Specter613/Proyecto_CEREST/docs/Analisis de Estabilidad/Analisis_de_estabilidad.pdf

## Análisis de estabilidad del cuadricóptero

C.E.R.E.S.T.

## Índice

1. Preliminares matemáticos y físicos | 2
2. Cinemática | 3
3. Dinámica traslacional | 4
4. Dinámica rotacional | 4
5. Representación alternativa del subsistema rotacional y translacional | 5
6. Arquitectura del controlador | 7
7. Análisis de estabilidad en lazo cerrado | 9

7.6.1. Con el lazo externo solo P no hay convergencia asintótica demostrable . . | 11
8. Sintonozación de ganancias | 12
9. Nomenclatura | 17

=====================================================================

## 1. Preliminares matemáticos y físicos

### 1.1. Marcos de referencia y convenciones

Se trabaja con dos marcos de referencia:

Marco inercial {I}, fijo a tierra, con ejes X e Y horizontales y eje Z hacia abajo (convención NED: North–East–Down). La posición del centro de masa es r = [x, y, z]

T; la altitud sobre
el suelo es h = −z.

Marco del cuerpo {B}, fijo al vehículo, con su eje zb hacia abajo cuando el vehículo está nive-lado. La orientación se parametriza con ángulos de Euler en convención ZYX: η = [ϕ, θ, ψ]

T
(roll, pitch, yaw).

Las convenciones que fijan todos los signos del documento son:

(C1) Gravedad. La fuerza de gravedad en {I} es mg e3, con e3 = [0, 0, 1]T y g = 9,81 m/s
2
Es positiva en z precisamente porque z apunta hacia abajo. Escribir −mg e3 correspon-dería a un eje Z hacia arriba y es incompatible con esta convención.

(C2) Empuje. El empuje total de los cuatro rotores tiene magnitud U1 ≥ 0 y actúa sobre el vehículo a lo largo de −b3, donde b3 = R(η)e3 es el eje zb expresado en {I}. En vuelo estacionario (hover), U1 = mg.

(C3) Geometría. Configuración en X: los cuatro rotores están sobre las diagonales del chasis, a distancia L del centro de masa; el brazo efectivo para roll y pitch es L/√
2.

(C4) Región de operación. Se trabaja en la región segura

D =

{︁

η : |θ| ≤ π
2 − εθ, |ϕ| ≤ π
2 − εϕ

}︁
, | εθ, εϕ > 0, | (1)

donde cos θ cos ϕ ≥ c0 > 0. Fuera de D la representación ZYX es singular y la proyección del empuje sobre z se anula: ningún resultado de este documento se afirma fuera de D.

### 1.2. Parámetros físicos del vehículo

Tabla 1: Parámetros físicos y aerodinámicos del cuadricóptero (valores reales del sistema).

Símbolo | Descripción | Unidades | Valor
m | Masa total del cuadricóptero | kg | 0,91870
g | Aceleración gravitacional | m/s² | 9,81
L | Distancia del centro a los motores | m | 0,165
kF | Constante de empuje aerodinámico | N/(rad/s)² | 6,53 × 10⁻⁶
kM | Constante de torque/arrastre | N·m/(rad/s)² 8,86 × 10⁻⁸
Ixx | Momento de inercia sobre el eje x | kg·m² | 6,5183 × 10⁻⁴
Iyy | Momento de inercia sobre el eje y | kg·m² | 1,0498 × 10⁻³
Izz | Momento de inercia sobre el eje z | kg·m² | 7,1227 × 10⁻⁴

El tensor de inercia se toma diagonal, I = diag(Ixx, Iyy, Izz), lo cual es consistente con la simetría de la configuración en X.

### 1.3. Herramientas de estabilidad que se utilizarán

El análisis usa dos resultados estándar, que se enuncian aquí en la forma exacta en que se aplicarán en la Sección 7.

Teorema 1.1 (Método directo de Lyapunov). Sea x˙ = f(x) con equilibrio en el origen y sea V (x) continua, diferenciable, con V (0) = 0 y V (x) > 0 para x ̸= 0 en una vecindad Ω. Si V˙ (x) ≤ 0 en Ω, el origen es estable en el sentido de Lyapunov. Si además V˙ (x) < 0 para x ̸= 0, es asintóticamente estable.

Teorema 1.2 (Principio de invariancia de LaSalle). Sea Ωc = {x : V (x) ≤ c} compacto y positivamente invariante, con V˙ ≤ 0 en Ωc. Sea S = {x ∈ Ωc : V˙ (x) = 0} y sea M el mayor conjunto invariante contenido en S. Entonces toda trayectoria que nace en Ωc tiende a M cuando t → ∞. En particular, si M = {0}, el origen es asintóticamente estable con región de atracción estimada Ωc.
El punto metodológico central del documento es que V˙ resultará solo semidefinida negativa: la estabilidad asintótica no se sigue del primer teorema y exige identificar M con cuidado, incluyendo los estados integrales del controlador en el estado del sistema (sin ellos el lazo cerrado con PID ni siquiera es un sistema autónomo sobre el que LaSalle pueda aplicarse).

## 2. Cinemática

### 2.1. Matriz de rotación ZYX

Con cα = cos α y sα = sin α, la matriz de rotación que lleva vectores de {B} a {I} es el producto de las rotaciones elementales en el orden ZYX, R(η) = Rz(ψ) Ry(θ) Rx(ϕ):

R(η) =

⎡

⎢
⎣
cψcθ | cψsθsϕ − sψcϕ | cψsθcϕ + sψsϕ
sψcθ | sψsθsϕ + cψcϕ | sψsθcϕ − cψsϕ
− sθ | cθsϕ | cθcϕ

⎤

⎥

⎦ . | (2)

b3 = R(η) e3 =

⎡

⎢
⎣

cψsθcϕ + sψsϕ
sψsθcϕ − cψsϕ
cθcϕ

⎤

⎥

⎦ , | (3)

es la dirección del eje zb en {I} y, por tanto, la dirección opuesta al empuje: el empuje total es −U1b3.

### 2.2. Relación entre velocidades angulares y ángulos de Euler

La velocidad angular del cuerpo, expresada en {B}, ξ = [p, q, r]

T, se relaciona con las
derivadas de los ángulos de Euler mediante ξ = W(η) η˙, con

W(η) =

⎡

⎢
⎣
1 | 0 | −sθ
0 | cϕ | cθsϕ
0 −sϕ | cθcϕ

⎤

⎥

⎦ , | detW(η) = cos θ. | (4)

## 3. Dinámica traslacional

### 3.1. Segunda ley de Newton en el marco inercial

Las fuerzas externas sobre el centro de masa son la gravedad mg e3 (hacia abajo, con signo positivo en esta convención) y el empuje −U1b3. La segunda ley de Newton en {I} da

m r¨ = mg e3 − U1 R(η) e3. | (5)

### 3.2. Expresión explícita

Sustituyendo (3) en (5) se obtiene la forma escalar exacta —sin ninguna aproximación—:

x¨ = −

U1
m

(︁
cψsθcϕ + sψsϕ

)︁
| , | (6)

y¨ = −

U1
m

(︁
sψsθcϕ − cψsϕ

)︁
| , | (7)

z¨ = g −

U1
m
cθcϕ. | | (8)

## 4. Dinámica rotacional

### 4.1. Ecuaciones de Euler en el marco del cuerpo

Con el tensor de inercia diagonal I = diag(Ixx, Iyy, Izz) y el par en el cuerpo τB = [τϕ, τθ, τψ]

| | T,
la ecuación de Euler es I

˙ξ = −ξ × Iξ + τB, es decir:

Ixx p˙ = (Iyy − Izz) qr + τϕ, Iyy q˙ = (Izz − Ixx) pr + τθ, Izz r˙ = (Ixx − Iyy) pq + τψ.

(9)

El término giroscópico −ξ×Iξ no realiza trabajo; en la representación alternativa de la Sección 5 reaparece dentro de la matriz de Coriolis, y es exactamente el término que la propiedad de antisimetría eliminará de V˙

### 4.2. Relación entre pares y velocidades de los rotores

Numerando los rotores 1 a 4 sobre las diagonales del chasis, con sentidos de giro alternados, distancia L al centro, constante de empuje kF y constante de par kM, la matriz de asignación correcta en configuración X —con el brazo efectivo L/√
2 en roll y pitch— es
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
kF | kF | kF | kF
− √

L
2
kF | − √ L
| 2
| kF | √ L
| | 2
| | kF | √ L
| | | 2 kF
− √

L
2
kF | √ L
| 2
| kF | √ L
| | 2
| | kF | − √ L
| | | 2 kF
− kM | kM | − kM | kM

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
, | (10)

donde U2 = τϕ, U3 = τθ, U4 = τψ y ωi es la velocidad angular del rotor i. Los signos concretos de las filas 2 y 3 dependen de la numeración adoptada para los rotores; lo que la demostración necesita —y lo que debe verificarse con la numeración real del vehículo— es que la matriz (10) sea invertible, lo cual ocurre si y solo si L, kF , kM ̸= 0.

### 4.3. Acoplamiento con la dinámica traslacional

La dinámica rotacional (9) no depende de r ni de r˙: la actitud evoluciona de forma autónoma bajo los pares τB. La dinámica traslacional (5), en cambio, depende de la actitud a través de R(η). El acoplamiento es, por tanto, triangular: rotación → traslación. Esta estructura es la que legitima la arquitectura en cascada de la Figura 1 —un lazo interno rápido de actitud y un lazo externo lento de posición—, pero no legitima analizar los lazos como si fueran independientes: la traslación hereda siempre el error de actitud, y la Sección 7.6 lo trata como lo que es, una perturbación del subsistema traslacional.

## 5. Representación alternativa del subsistema rotacional y translacional

### 5.1. Derivación

Partiendo del lagrangiano L = T − V con energía cinética T =

m
2

∥r˙∥

2 +
1/2 ξ

TIξ y energía
potencial gravitatoria Vg = −mgz —negativa en z porque, con Z hacia abajo, perder altitud es ganar z—, las ecuaciones de Euler–Lagrange entregan el modelo completo en la forma estándar de un sistema mecánico:

M(q) q¨ + C(q, q˙) q˙ + g(q) = B(η) U, q =

[︄
r
η

]︄
, U =

[︄
U1
τB

]︄
. | (11)

### 5.2. Representación alternativa del subsistema traslacional

El bloque traslacional de (11) es inmediato: Mt = mI3 constante, Ct = 03×3, y el vector gravitatorio correcto en esta convención es gt = −mg e3 en el lado izquierdo de la ecuación, equivalente a +mg e3 como fuerza en (5). Su única no trivialidad está en la entrada: la fuerza generalizada traslacional es −U1R(η)e3, que depende de la actitud completa.

### 5.3. Propiedades estructurales

La forma completa de las matrices de (11) es

M(q) = diag(︁
mI3, Mo(η)

)︁

, C(q, q˙) = diag(︁
03×3, Co(η, η˙)

)︁

, g(q) = [︄
−mg e3
0

]︄
,

(12)

B(η) U =

[︄
−U1R(η)e3
W(η)

−T
τo

]︄
, τo = W(η)

T
τB. | (13)

Tres observaciones sobre (11)–(13). Primera: M(q) no es una matriz 6 × 6 arbitraria; es diagonal por bloques porque la energía cinética se separa en traslación y rotación, pero el sistema sigue siendo uno solo: el acoplamiento vive en la matriz de entrada B(η), que mezcla actitud y traslación a través de R(η). Segunda: B(η) tiene rango 4 < 6 en todo punto, que es la forma precisa de decir que el sistema es subactuado. Tercera: demostrar estabilidad “por subsistemas independientes” equivaldría a ignorar B(η), es decir, a demostrar otro sistema distinto del vehículo.

Propiedad 5.1 (Mo simétrica y definida positiva). Para todo η ∈ D, Mo(η) = Mo(η)

T y
existen 0 < λm ≤ λM tales que λm∥x∥

2 ≤ x

TMo(η) x ≤ λM∥x∥
2 para todo x ∈ R

3
. En efecto,
x

TMox = (W x)

TI(W x) con W x ̸= 0 si x ̸= 0, porque W es invertible en D e I es definida positiva; las cotas uniformes existen porque D puede tomarse compacto y Mo es continua.

Propiedad 5.2 (Antisimetría). Con Co construida mediante los símbolos de Christoffel de Mo (Sección 5.4), la matriz M˙
o(η)−2Co(η, η˙) es antisimétrica; en particular, x

T

(︁M˙
o −2Co

)︁
x = 0
para todo x ∈ R

3
. Es la traducción algebraica de que las fuerzas de Coriolis y centrífugas no realizan trabajo.

Propiedad 5.3 (Bloque traslacional). M˙
t − 2Ct = 0, trivialmente antisimétrica, porque Mt = mI3 es constante y Ct = 0. El bloque traslacional aporta a V˙ únicamente a través de la matriz de entrada B(η), nunca a través de un término de Coriolis.

### 5.4. Construcción de las matrices Mo y Co

Sustituyendo ξ = W(η)η˙ en la ecuación de Euler (9) y premultiplicando por W(η)

T se
obtiene el bloque rotacional en ángulos de Euler,

Mo(η) η¨ + Co(η, η˙) η˙ = τo, Mo(η) = W(η)

T
I W(η), | (14)

con Co construida con los símbolos de Christoffel de Mo:

[Co]kj =

∑︂

3

i=1

cijk η˙i

, cijk =

1
2

(︄
∂mkj
∂ηi

+

∂mki
∂ηj

−

∂mij
∂ηk

)︄
. | (15)

La construcción (15) —y no otra elección de Co, que no es única— es la que garantiza la Propiedad 2. La expresión explícita de Mo(η), calculada simbólicamente a partir de (14), es

Mo(η) =

⎡

⎢
⎣
Ixx | 0 | −Ixxsθ
0 | Iyyc
| 2 ϕ + Izzs
| 2 ϕ | (Iyy − Izz) sϕcϕcθ
−Ixxsθ | (Iyy − Izz) sϕcϕcθ | Ixxs
| | 2 θ + Iyys
| | 2 ϕ
c
| | 2 θ + Izzc

2
ϕ

c

2
θ

⎤

⎥

⎦ . | (16)

Observación 5.1. La matriz Co explícita debe generarse por código a partir de (15), no copiarse a mano: una Co escrita término a término no satisface en general C31 = −C13 ni C32 = −C23 elemento a elemento —la antisimetría de la Propiedad 2 es de la combinación M˙
o − 2Co, no
de Co por separado— y sus entradas C22, C33 no son cero en general. Cualquier Co “explícita” que no provenga de (15) invalida el paso clave de la Sección 7.4.

### 5.5. Representación del subsistema rotacional

El subsistema rotacional completo, en la representación alternativa, es (14) con (16): una ecuación tipo manipulador con inercia dependiente de la configuración Mo(η), Coriolis Co(η, η˙) y entrada el par generalizado τo = WTτB. Nótese que el PID de actitud de la Sección 6 se diseña sobre τo y se implementa sobre el par físico como τB = W(η)

−T
τo, válido en D donde
detW = cos θ ̸= 0; no es lícito “absorber” W en las ganancias.

### 5.6. Representación del subsistema traslacional

El subsistema traslacional, en la misma representación, es

m r¨ − mg e3 = −U1R(η) e3, | (17)

es decir, (5) reordenada. Su lectura en la forma (11) deja claro el punto que ordena todo el análisis: el subsistema traslacional tiene inercia constante y Coriolis nula, pero su entrada está multiplicada por R(η); por eso el lazo traslacional y el rotacional forman un solo sistema acoplado aunque M y C sean diagonales por bloques.

## 6. Arquitectura del controlador

fig_arquitectura_controlador.png

Figura 1: Diagrama a bloques del controlador en cascada (figura original del autor). El lazo externo de posición no produce fuerzas: produce los ángulos deseados ϕd y θd que alimentan al lazo interno de actitud.

### 6.1. Descripción de los bloques

La lectura correcta de la Figura 1, coherente con la subactuación del modelo (11), es la siguiente. Hay lazos PID sobre variables medidas directamente actuadas por cada entrada — altitud sobre U1, actitud sobre U2, U3 y guiñada sobre U4— y un lazo externo proporcional cuya salida es una referencia para el lazo interno, no una fuerza:

1. Controlador de altitud (Altitude Controller): compara z con zd y genera U1 mediante un PID con compensación de gravedad y proyección sobre cθcϕ (Sección 6.3).
2. Controlador de actitud (Attitude Controller): compara (ϕ, θ) con (ϕd, θd) y genera los pares U2, U3 mediante un PID en coordenadas generalizadas (Sección 6.4).
3. Controlador de posición (Position Controller): compara (x, y) con (xd, yd) con acción proporcional y genera ϕd, θd invirtiendo exactamente la relación de fuerzas (Sección 6.2).

4. Controlador de guiñada (Heading Controller): compara ψ con ψd y genera U4; se trata junto con el controlador de actitud como un único PID sobre η (Sección 6.4).
5. Dinámica del cuadricóptero (Quadrotor Dynamics): el sistema (11), con sus subsistemas traslacional y rotacional acoplados por R(η).

### 6.2. Lazo externo de posición (P): control virtual y ángulos deseados

Para regulación se fijan xd, yd constantes. El controlador de posición es proporcional sobre el error ex = xd − x, ey = yd − y, y su salida es una aceleración horizontal deseada:

adx = Kpxex, | ady = Kpyey, | Kpx, Kpy > 0. | (18)

La aceleración deseada se convierte en actitud deseada invirtiendo exactamente la relación (5). Imponiendo mad = mg e3 − U1b3d se obtiene el eje deseado

b3d =

m
U1

⎡

⎢
⎣

−adx

−ady

g − adz

⎤

⎥

⎦ , | con ∥b3d∥ = 1 tras normalizar, | (19)

donde adz es la aceleración vertical comandada por el lazo de altitud (Sección 6.3). Extrayendo ϕd y θd de (19) para el ψd fijado, y escribiendo la forma de ángulos pequeños que resulta de (19) —exacta en el límite y útil para interpretar los signos, coherente con (??)—, se obtiene

θd = −

adxcψ + adysψ
g

, ϕd =

− adxsψ + adycψ
g
. | (20)

Las referencias (20) se saturan a la región D: |ϕd|, |θd| ≤ π/2−ε. Toda afirmación de estabilidad de este documento supone que esa saturación no está activa; con saturación activa el resultado pasa a ser, como máximo, de estabilidad práctica en una vecindad.

### 6.3. Lazo de altitud (PID): U1 proyectado

Sea ez = zd − z con zd constante, y ζz el estado integral, ˙ζz = ez. El lazo de altitud no pide una “fuerza en z” abstracta: pide la aceleración vertical adz = Kpzez +Kdze˙z +Kizζz y la realiza con el único empuje disponible, dividiendo por la proyección vertical del eje de empuje:

U1 =

m

[︁
g − Kpzez − Kdze˙z − Kizζz

]︁
cθcϕ
. | (21)

Sustituyendo (21) en (8) se obtiene exactamente —sin linealizar— la dinámica de error cerrada

e¨z + Kdze˙z + Kpzez + Kizζz = 0,

˙ζz = ez, | (22)

válida mientras cθcϕ ≥ c0 > 0 en D y mientras U1 ∈ (0, U1,m´ax], es decir, mientras el numerador de (21) se mantenga positivo y no sature. La compensación de gravedad está incluida en (21): el término g dentro del corchete es la alimentación directa (feedforward) que en hover da U1 = mg.

### 6.4. Lazos de actitud y guiñada (PID): pares generalizados

Sea eη = ηd − η el error de actitud, con ηd = [ϕd, θd, ψd]

T, y ζη su integral, ˙ζη = eη. Los controladores de actitud y de guiñada de la Figura 1 se escriben como un único PID en coordenadas generalizadas, con ganancias diagonales Kp, Kd, Ki ≻ 0:

τo = Kpeη + Kde˙η + Kiζη, τB = W(η)

−T
τo. | (23)

Observación 6.1 (Anti-windup). La demostración supone integradores sin saturación ni anti-windup. Si el vehículo real usa anti-windup, este debe desactivarse para la validez literal del teorema, o el teorema debe leerse como válido en la región donde el anti-windup no actúa.

## 7. Análisis de estabilidad en lazo cerrado

### 7.1. Construcción del lazo cerrado en términos del error

El lazo fuerte es el subsistema (z, η) con entradas (U1, τB): cuatro variables controladas y las cuatro entradas reales del vehículo. Su estado de error aumentado —que incluye los integradores, porque un PID sin su integral no es un sistema autónomo analizable por LaSalle— es

X =

(︁
ez, e˙z, ζz, eη, e˙η, ζη

)︁
∈ R

12
,

˙ζz = ez,

˙ζη = eη. | (24)

El acoplamiento entre altitud y actitud persiste en dos lugares: en Mo(η) y Co(η, η˙), que dependen del estado rotacional completo, y en la condición de validez de (21), que exige cθcϕ ≥ c0 > 0.

### 7.1.1. Lazo cerrado del subsistema traslacional

El lazo traslacional no se cierra con un PID vectorial sobre r: no existe un vector de fuerzas independiente por eje. Se cierra sobre z con (22), que es exacta, y sobre (x, y) indirectamente, a través de los ángulos deseados (20). En el teorema principal, ηd se toma constante —el caso de regulación, en el que además ϕd = θd = 0 en el equilibrio—. El caso de (x, y) con referencias internas variables se trata aparte, en la Sección 7.6, porque es allí donde la arquitectura P–PID muestra su límite.

### 7.1.2. Lazo cerrado del subsistema rotacional

Con ηd constante se tiene e˙η = −η˙, y sustituyendo (23) en (14) se obtiene la dinámica de error rotacional en lazo cerrado:

Mo(η) e¨η +

[︁
Co(η, η˙) + Kd

]︁
e˙η + Kpeη + Kiζη = 0. | (25)

Obsérvese que (25) conserva íntegros Mo(η) y Co(η, η˙): no se ha cancelado el término de Coriolis ni se ha sustituido Mo por su valor en hover. El controlador es el PID implementado; la no linealidad queda dentro del lazo y es la función de Lyapunov la que la absorbe, vía la Propiedad 2.

### 7.2. Función candidata de Lyapunov

Se propone, sobre el estado aumentado (24), la energía total del error:

V (X) = m
2

e˙

2
z +

1
2

Kpze

2
z +

1
2

Kizζ

2
z

+

1
2

e˙

T
ηMo(η) e˙η +

1
2

e

T
η Kpeη +

1
2

ζ

T
η Kiζη.

(26)

Cada término tiene lectura física: energía cinética del error, energía potencial del “resorte” proporcional y energía acumulada por el integrador. El término integral es el que el análisis ingenuo incluye sin definir el estado ζ que lo hace legítimo: sin ese estado, (26) no es una función del estado y su derivada no está bien definida.

### 7.3. Demostración de que V es definida positiva

Si Kpz, Kiz > 0 y Kp, Ki son simétricas definidas positivas, cada sumando de (26) es una forma cuadrática definida positiva en su variable, y el término cinético rotacional lo es por la Propiedad 1: λm
2

∥e˙η∥

2 ≤
1/2 e˙

T
ηMoe˙η ≤

λM
2

∥e˙η∥

2
. Luego V (0) = 0 y V (X) > 0 para X ̸= 0.

Además, de (26) se lee directamente una cota para los ángulos: si V (X) ≤ c, entonces |eϕ| ≤ √︂
2c/λm´ın(Kp), y análogamente para θ y ψ. Eligiendo

c <

1
2

λm´ın(Kp)

(︃

π
2

− ε

)︃2
, Ωc =

{︁
X : V (X) ≤ c

}︁
∩ D, | (27)

el conjunto Ωc queda estrictamente dentro de D, es compacto y —una vez demostrado que V˙ ≤ 0— es positivamente invariante: ninguna trayectoria que nazca en Ωc puede acercarse a la singularidad θ = ±π/2 ni anular la proyección cθcϕ por la que (21) divide. Ωc es la “región deseada” de la demostración, y (27) es la primera condición que liga las ganancias con la región: aumentar λm´ın(Kp) permite certificar la misma región con un c mayor, es decir, con errores iniciales admisibles mayores.

### 7.4. Demostración de que V˙ ≤ 0

Derivando (26) a lo largo de las trayectorias y sustituyendo las dinámicas de error (22) y (25):

V˙ = ˙ez
[︁
me¨z + Kpzez + Kizζz

]︁
+ e˙

T
η

[︁Mo(η) e¨η + Kpeη + Kiζη

]︁
+

1
2

e˙

T

ηM˙
o(η) e˙η. (28)

Sustituyendo me¨z = −Kdze˙z − Kpzez − Kizζz y Moe¨η = −[Co + Kd]e˙η − Kpeη − Kiζη, los términos proporcionales e integrales se cancelan exactamente en ambos bloques —almacenan energía, no la disipan— y queda

V˙ = −Kdz e˙
2
z − e˙

T
η Kd e˙η +

1
2

e˙

T
η

[︁M˙
o(η) − 2Co(η, η˙)

]︁
| | e˙η. | (29)

El último sumando es idénticamente cero por la Propiedad 2, con x = e˙η. Por tanto:

V˙ (X) = −Kdz e˙
2
z − e˙

T
η Kd e˙η ≤ 0 | si Kdz > 0, Kd ≻ 0. | (30)

V˙ es solo semidefinida negativa: se anula en todo el conjunto {e˙z = 0, e˙η = 0}, que contiene muchos estados con e ̸= 0. Por el método directo, (26) y (30) demuestran estabilidad en el sentido de Lyapunov del origen del error, y nada más todavía. Afirmar convergencia desde aquí sería incorrecto; hace falta el principio de invariancia.

### 7.5. Aplicación del teorema de Barbashin–Krasovskii–LaSalle

Sea S = {X ∈ Ωc : V˙ (X) = 0} = {e˙z = 0, e˙η = 0} y sea M el mayor conjunto invariante contenido en S. Sobre una trayectoria contenida en M se tiene e˙z ≡ 0 y e˙η ≡ 0 para todo t; luego ez y eη son constantes, e¨z ≡ e¨η ≡ 0, y los integradores evolucionan como ζz(t) = ζz(0)+ezt y ζη(t) = ζη(0)+eηt. Sustituyendo en las dinámicas de lazo cerrado, que deben satisfacerse para todo t:
Kpzez + Kizζz(t) = 0, | Kpeη + Kiζη(t) = 0 | ∀ t. | (31)
(31) no implica e = 0 por sí sola, porque un error constante podría, en principio, quedar compensado por el integrador. Lo que lo impide es derivar (31) respecto de t y usar ˙ζ = e:
Kizez = 0 ⇒ ez = 0, | Kieη = 0 ⇒ eη = 0, | | (32)

porque Kiz > 0 y Ki es definida positiva, luego invertible. Con e = 0, de (31) se sigue ζz = 0 y ζη = 0. Por tanto M = {0}: el único estado que puede permanecer para siempre en S es el origen completo del estado aumentado, integradores incluidos.

Teorema 7.1 (Estabilidad asintótica del lazo fuerte). Sean zd y ψd constantes, ϕd = θd = 0, ganancias Kpz, Kdz, Kiz > 0 y Kp, Kd, Ki diagonales definidas positivas, y c elegido según (27). Entonces el origen del estado de error aumentado (24) del sistema acoplado altitud–actitud en lazo cerrado con (21)–(23) es asintóticamente estable, y toda trayectoria que nace en Ωc converge a él: ez, eη → 0, e˙z, e˙η → 0 y ζz, ζη → 0 cuando t → ∞. El resultado es local a Ωc ⊂ D y supone entradas sin saturar e integradores sin anti-windup activo.

Corolario 7.2 (Rechazo de perturbaciones constantes). El mismo argumento, con un error constante de modelado en la masa, desplaza el equilibrio del integrador a ζ

∗ ̸= 0 manteniendo
e = 0: la acción integral absorbe el error constante de masa o de empuje en hover sin error permanente en z ni en η. La demostración es idéntica, trabajando con el estado trasladado ζ−ζ

∗

### 7.6. Qué se puede afirmar sobre x e y, y qué no

### 7.6.1. Con el lazo externo solo P no hay convergencia asintótica demostrable

Supóngase el caso más favorable posible: el lazo interno es perfecto, η ≡ ηd en todo instante, y U1 mantiene exactamente la aceleración vertical comandada. Entonces, por construcción (18)– (19), la traslación horizontal obedece x¨ = adx = Kpxex y y¨ = ady = Kpyey, es decir:

e¨x + Kpxex = 0, | e¨y + Kpyey = 0. | (33)

El sistema (33) es un oscilador armónico sin amortiguamiento: su energía 1
2

e˙

2
x +

1
2Kpxe

2
x

se
conserva exactamente, V˙ ≡ 0, y sus trayectorias son órbitas cerradas alrededor del origen, no trayectorias que converjan a él. El origen es estable en el sentido de Lyapunov, pero no asintóticamente estable, y ninguna función de Lyapunov puede demostrar lo contrario, porque la afirmación sería falsa. En el sistema real el lazo interno no es perfecto y su retardo introduce fase que en la práctica a veces amortigua y a veces desestabiliza (33) —la validación numérica de la Sección 8.5 muestra el caso desfavorable: la amplitud crece—; en ningún caso constituye una garantía.

Observación 7.1 (Alcance honesto). Con la arquitectura tal como está dibujada en la Figura 1, los estados esenciales y demostrables son z, ϕ, θ y ψ (Teorema 7.1). De x e y solo puede afirmarse acotamiento en el modelo reducido ideal (33).

### 7.6.2. Modificación mínima que sí cierra la demostración

Basta añadir acción derivativa al lazo externo —que pasa de P a PD, manteniendo intacta la estructura P–PID en cascada y todos los lazos internos—:

adx = Kpxex + Kdxe˙x, | ady = Kpyey + Kdye˙y, | Kdx, Kdy > 0. | (34)

Con (34), el subsistema reducido de posición tiene por función de Lyapunov Vxy =

1/2( ˙e

2
x + ˙e
| | | 2 y
) +

1
2Kpxe

2
x +

1
2Kpye

2

y y derivada V˙
xy = −Kdxe˙

2
x − Kdye˙

2
y ≤ 0, y LaSalle entrega ex, ey → 0 sobre el sistema reducido.
El paso del sistema reducido al sistema completo es un argumento en cascada, no una iden-tidad: escríbase la traslación real como el sistema reducido más un término forzado por el error de actitud eη y por e˙η. Como el Teorema 7.1 hace que ese forzamiento tienda a cero y el subsistema (34) es estable ante entradas que se desvanecen (es lineal y exponencialmente estable), el teorema de estabilidad en cascada y la propiedad de estabilidad entrada–estado (ISS) del bloque lineal permiten concluir ex, ey → 0 para el sistema completo, bajo la hipótesis adicional —que debe declararse— de que las ganancias externas son suficientemente lentas frente a las internas (Sección 8.4) y de que ϕd, θd generados por (20) permanecen en D. Esa es la forma rigurosa de usar la separación de escalas: como hipótesis verificable de un teorema en cascada, no como justificación para desacoplar las ecuaciones a mano.

## 8. Sintonozación de ganancias

### 8.1. Lo que la demostración necesita

Para el Teorema 7.1 no hace falta ningún valor numérico: bastan las condiciones cualitativas Kpz, Kdz, Kiz > 0, Kp, Kd, Ki simétricas definidas positivas (en la práctica, diagonales con entradas positivas), la condición de región (27) y U1 sin saturar. Toda ganancia que cumpla esas condiciones da un lazo fuerte asintóticamente estable en Ωc. Los valores concretos solo deciden el tamaño útil de Ωc, la velocidad de convergencia y el margen frente a la saturación: por eso se calculan aparte, con un modelo escalar por canal, y por eso ese cálculo —que sí usa el modelo en hover— no forma parte de la demostración.

### 8.2. Cálculo por asignación de polos en hover (solo para sintonizar)

Cerca de hover, Mo(η) ≈ diag(Ixx, Iyy, Izz) y cada canal PID —altitud con inercia m, roll con Ixx, pitch con Iyy, yaw con Izz— tiene por polinomio característico, con inercia genérica J:

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
2 + 2ζωns + ω

2
n

### )︁(︁s + pi

)︁
, | (35)

de donde, igualando coeficientes, se obtiene la receta de cálculo de las ganancias ideales:

Kd = J

(︁
2ζωn + pi

)︁
, Kp = J

(︁
ω

2
n + 2ζωnpi

)︁
, Ki = J pi ω

2
n

(36)

con ωn la frecuencia natural deseada del canal, ζ ∈ [0,7, 1,0] el amortiguamiento y pi ≈ ωn/5 . . . ωn/10 la velocidad del polo integral —lento a propósito: un integrador rápido es la causa habitual de inestabilidad en PID de actitud—.
La condición de Routh–Hurwitz del polinomio (35), escrita con las ganancias normalizadas kp = Kp/J, kd = Kd/J, ki = Ki/J, es

kd kp > ki

, | (37)

y la receta (36) la satisface automáticamente, pues kdkp = (2ζωn +pi)(ω

2
n + 2ζωnpi) > piω

2
n = ki
para ζ, ωn, pi > 0. Es decir: (36) no solo sintoniza, garantiza que el canal sintonizado respete la condición de estabilidad del tercer orden.
Ejemplo numérico completo, canal de altitud. Con J = m = 0,91870 kg, eligiendo ωn = 2,0 rad/s, ζ = 0,8 y pi = 0,5 rad/s, la receta (36) da:

Tabla 2: Ganancias propuestas del canal de altitud, de (36).

Magnitud | Cálculo | Valor
Kdz | 0,91870 · (2 · 0,8 · 2,0 + 0,5) = 0,91870 · 3,7 | 3,40 N·s/m
Kpz | 0,91870 · (2,0
| 2 + 2 · 0,8 · 2,0 · 0,5) = 0,91870 · 5,6 | 5,14 N/m
Kiz | 0,91870 · 0,5 · 2,0
| 2 = 0,91870 · 2,0 | 1,84 N/(m·s)

Verificación de (37) en altitud, con ganancias normalizadas (kd, kp, ki) = (3,7, 5,6, 2,0): kdkp = 20,72 > 2,0 = ki

. ✓

### 8.3. Ganancias propuestas

El mismo cálculo con J = Ixx, Iyy, Izz de la Tabla 1 entrega las ganancias de actitud. El diseño normalizado adoptado es: altitud ωn = 2,0 rad/s, ζ = 0,8, pi = 0,5; lazo externo x–y ωn = 1,2 rad/s, ζ = 1,0; actitud roll/pitch ωn = 6 rad/s, ζ = 1,0, pi = 2,5; yaw ωn = 3,5 rad/s, ζ = 1,0, pi = 2,0.

Tabla 3: Ganancias propuestas (variante base, ωn de actitud 6/3,5 rad/s).

Canal | Kp | Kd | Ki | Routh normalizado kdkp > ki
Altitud z | 5,14 | 3,40 | 1,84 | 20,7 > 2,0 ✓
x–y (externo) 1,44 | 2,40 (PD) / 0 (P) — | —
Roll ϕ | 0,0430 | 0,00945 | 0,0587 | 957 > 90 ✓
Pitch θ | 0,0693 | 0,01522 | 0,0945 | 957 > 90 ✓
Yaw ψ | 0,0187 | 0,00641 | 0,0175 | 236 > 24,5 ✓

Las ganancias de altitud y de x–y no dependen de las inercias; las de actitud son proporcionales a J y deben recalcularse si las inercias cambian: usar ganancias calculadas con inercias diez veces mayores dejaría el lazo de actitud diez veces más rígido en términos normalizados (ωn ≈ 25 rad/s), fuera del rango recomendado de la Sección 8.4 y con mucho más riesgo de saturar los motores y amplificar el ruido.

### 8.4. Separación de anchos de banda y región deseada

Actitud. Lazo interno de actitud: ωn entre 8 y 15 rad/s en el diseño definitivo.

Altitud. Lazo de altitud: ωn entre 2 y 4 rad/s.

Posición. Lazo externo de posición (con la modificación PD de (34)): ωn entre 0,5 y 1,5 rad/s, al menos 5 veces más lento que el de actitud. Esta razón de separación es la versión operativa de la hipótesis del argumento en cascada de la Sección 7.6.

Región. Dada una región angular deseada |ϕ|, |θ| ≤ αm´ax < π/2, elíjase Kp de actitud de modo que (27) admita el c correspondiente a los errores iniciales previstos: en la práctica, verifíquese que V (X(0)) ≤ c para el peor error inicial esperado, con c =

| | | | 1
| | | | 2 λm´ın(Kp) α

2
m´ax
como cota conservadora.

Variante con ωn de actitud en el rango recomendado. Con roll/pitch en ωn = 10 rad/s y yaw en ωn = 8 rad/s (ζ = 1,0; pi = 2,5 y 2,0), la receta (36) da:

Tabla 4: Ganancias propuestas, variante ωn = 10/8 rad/s.

Canal | Kp | Kd | Ki | Routh normalizado
Roll ϕ | 0,0978 | 0,01467 | 0,1630 | 3375 > 250 ✓
Pitch θ | 0,1575 | 0,02362 | 0,2625 | 3375 > 250 ✓
Yaw ψ | 0,0684 | 0,01282 | 0,0912 | 1728 > 128 ✓

La separación de anchos de banda de esta variante es 10/1,2 ≈ 8,3 veces frente a posición y 10/2,0 = 5 veces frente a altitud. Su coste en esfuerzo de control y en velocidad exigida a los motores se cuantifica en la Sección 8.5.

### 8.5. Validación numérica sobre el modelo no lineal exacto

### 8.5.1. Protocolo de simulación

Se simula el modelo exacto (5)–(9) —NED, ZYX, configuración en X, sin linealización— con los parámetros reales de la Tabla 1 y las ganancias de la Tabla 3. Referencias fijas: rd = [1,0, −0,8, −1,5] m (en NED, zd = −1,5 m equivale a 1,5 m de altura) y ψd = 0,3 rad. Condición inicial: r0 = 0, η0 = [0,25, −0,20, −0,30] rad, velocidades nulas. Horizonte 15 s, integración RK45 con rtol = 10⁻⁸
. Saturaciones aplicadas: F ∈ [0, 20] N, |τ | ≤ 0,6 N·m, |ϕd|, |θd| ≤ 0,35 rad.

Se comparan dos casos que difieren solo en el lazo externo: Caso A, P solo en x–y (Kd,xy = 0, la arquitectura original), y Caso B, P+D en x–y (la modificación (34)).

### 8.5.2. Resultados

1. El lazo fuerte sí converge. En ambos casos ez, eϕ, eθ, eψ → 0. El seguimiento de actitud es bueno incluso en el Caso A (error final −2,6

◦
, 1,7

◦
): el lazo interno no es el problema, tal como predice el Teorema 7.1.
2. P solo en x–y no basta. Con Kd,xy = 0 el error horizontal oscila con amplitud creciente —de ±1,4 m a más de ±3 m en 15 s—: el modelo reducido (33) no tiene amortiguamiento y el retardo real del lazo interno lo desestabiliza en la práctica. Es la evidencia numérica de la Sección 7.6.
3. Con P+D sí hay convergencia. Caso B: errores a cero en ≈ 5 s en x–y y ≈ 7 s en z, controles sin saturar, y la función V = z

TP z del estado de error completo —con P solución de ATP + P A = −I del sistema nominal, no la energía diagonal— decrece de 6,49 a ≈ 0 con V˙ ≤ 0 en todo el intervalo.

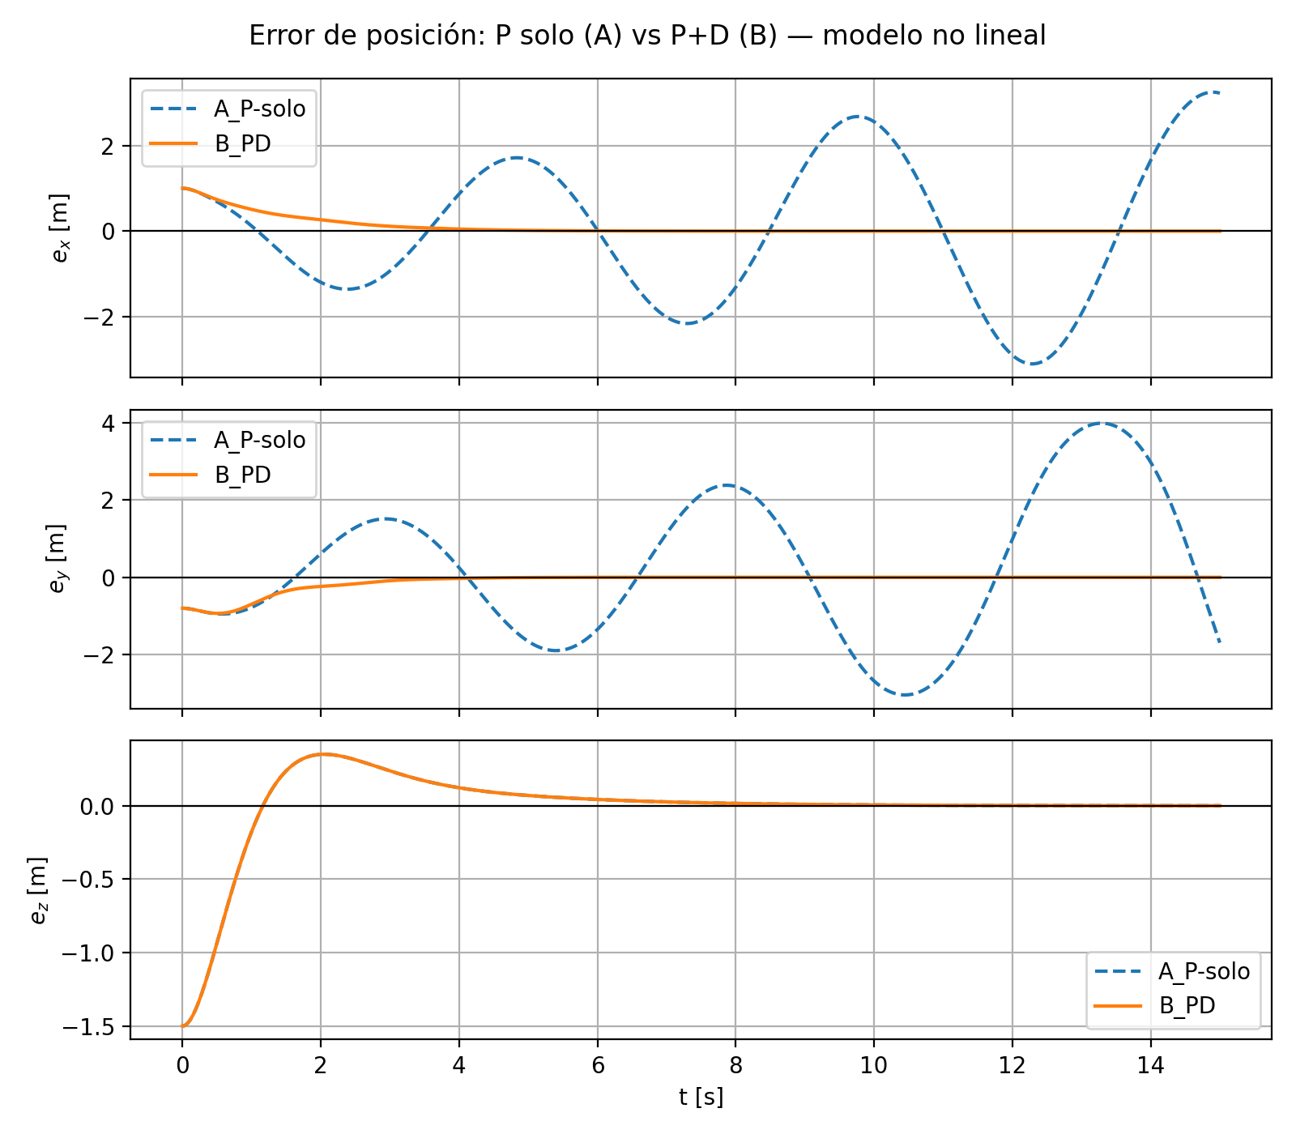
[picture p3: figure]

Figura 2: Errores de posición ex, ey, ez: Caso A (P solo en x–y, oscilación creciente) frente a Caso B (P+D, convergencia).

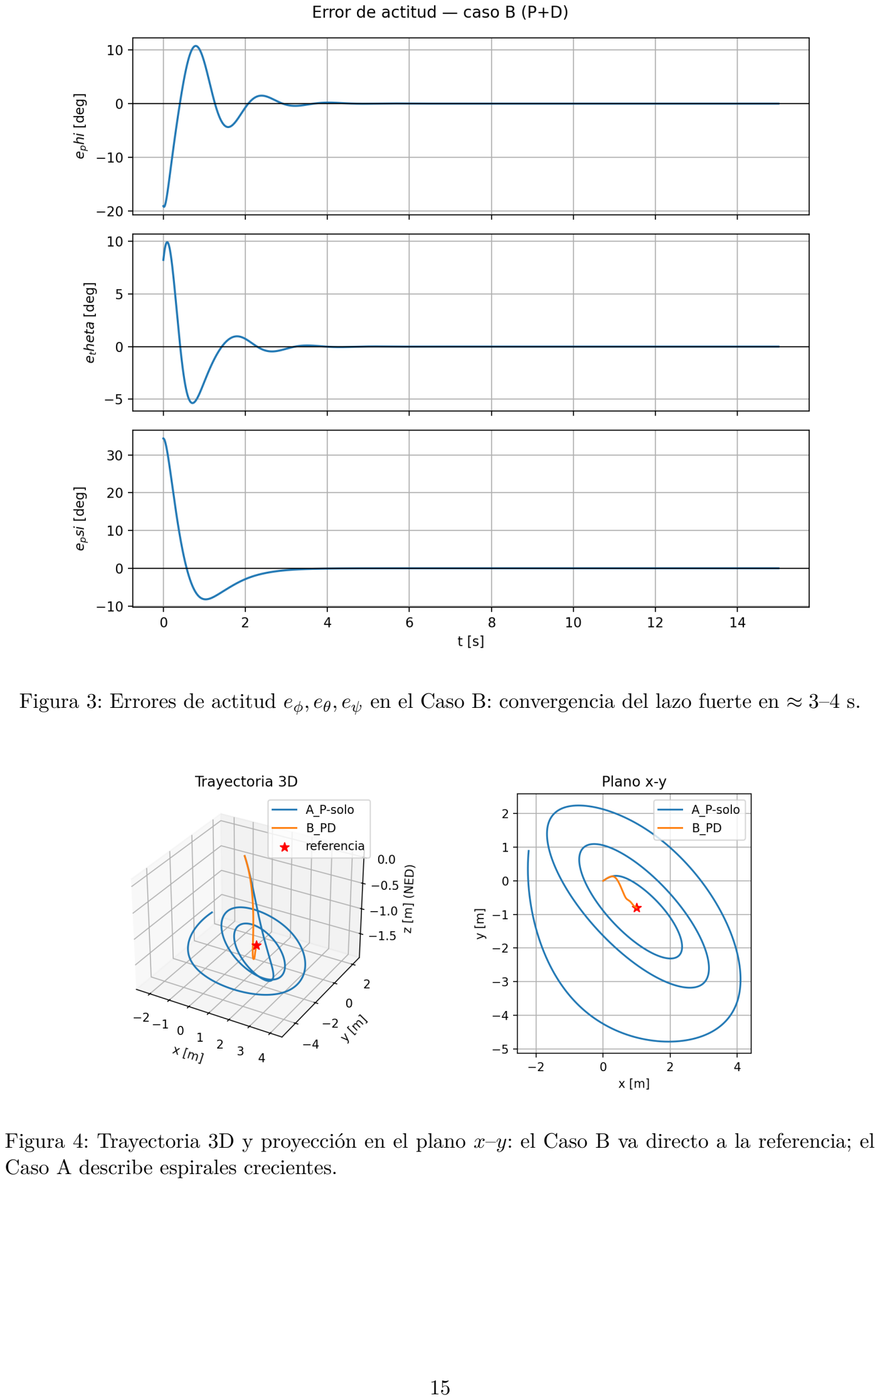
[picture p4: page 15]

Figura 3: Errores de actitud eϕ, eθ, eψ en el Caso B: convergencia del lazo fuerte en ≈ 3–4 s.

Figura 4: Trayectoria 3D y proyección en el plano x–y: el Caso B va directo a la referencia; el Caso A describe espirales crecientes.

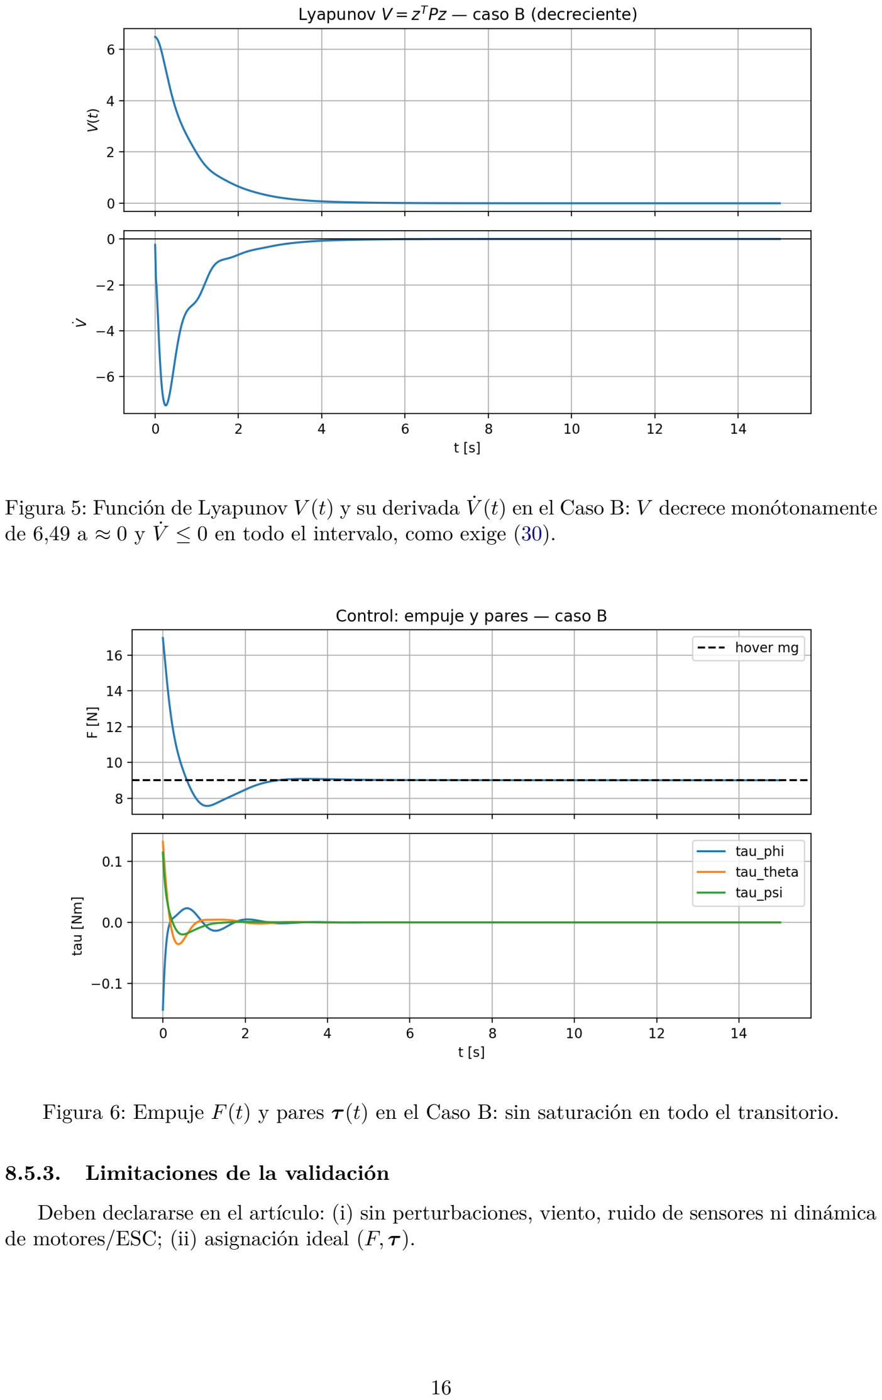
[picture p5: page 16]

Figura 5: Función de Lyapunov V (t) y su derivada V˙ (t) en el Caso B: V decrece monótonamente de 6,49 a ≈ 0 y V˙ ≤ 0 en todo el intervalo, como exige (30).

Figura 6: Empuje F(t) y pares τ (t) en el Caso B: sin saturación en todo el transitorio.

### 8.5.3. Limitaciones de la validación

Deben declararse en el artículo: (i) sin perturbaciones, viento, ruido de sensores ni dinámica de motores/ESC; (ii) asignación ideal (F, τ ).

## 9. Nomenclatura

Tabla 5: Nomenclatura del documento.
Símbolo | Descripción | Unidades

r = [x, y, z]

T | Posición del centro de masa en {I}, con z hacia
| abajo | m

η = [ϕ, θ, ψ]

T | Ángulos de Euler ZYX (roll, pitch, yaw) | rad
ξ = [p, q, r]
T | Velocidad angular en {B} | rad/s
R(η), W(η) | Matriz de rotación y mapa de velocidades angu-
| lares | —
Mo(η), Co(η, η˙) | Inercia y Coriolis en la representación alternativa
| rotacional | kg·m² , —
U1 | Empuje total (magnitud), a lo largo de −b3 | N
U2, U3, U4 | Pares de roll, pitch y yaw en la asignación (10) | N·m
τB, τo | Par en el cuerpo y par generalizado, τo = WTτB | N·m
ez, eη, ζz, ζη | Errores de altitud y actitud y sus estados integra-
| les | m, rad, m·s, rad·s
Kp, Kd, Ki | Ganancias PID de actitud (diagonales, definidas
| positivas) | según canal
Kpz, Kdz, Kiz | Ganancias PID de altitud | según canal
Kpx, Kpy | Ganancias P del lazo externo de posición | 1/s²
m, g | Masa total y aceleración gravitatoria | kg, m/s²
L, kF , kM | Distancia centro–rotor y constantes de empuje y
| de par | m, N/(rad/s)²

, N·m/(rad/s)²

D, Ωc | Región segura de representación y región de
| atracción estimada, ec. (27) | —
