Specter613/Proyecto_CEREST/Visualizador_RViz2/visrviz_ws/src/dron_sim_pkg/meshes/ensamble_dron.stl

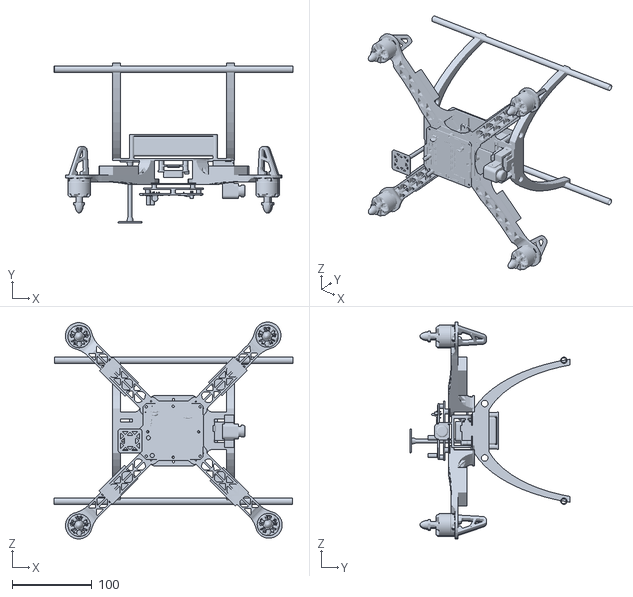
[picture p6: CAD file, 2026-11-03]
Visualizador_RViz2/visrviz_ws/src/dron_sim_pkg/meshes/ensamble_dron.stl
300.4 x 200.9 x 272.5
