Specter613/Proyecto_CEREST/Firmware_CEREST/Core/Inc/puente.h

/*
 * Puente.h
 *
 *  Created on: 6 ago 2026
 *      Author: specter0163
 */

#ifndef INC_PUENTE_H_
#define INC_PUENTE_H_

#include <stdbool.h>

#ifdef __cplusplus
extern "C"{
#endif

void App_Init();
void App_Loop();
void App_Comando(char *cmd);



#ifdef __cplusplus
}
#endif


#endif /* INC_PUENTE_H_ */
