Specter613/Proyecto_CEREST/(commit log)

2026-11-03 feat: Actualiza scripts de procesamiento de imágenes y agrega carpetas de visualizadores y archivo .md
    [dron_urdf.urdf, ensamble_dron.stl]
2026-11-03 Adisión de .md's y modificación de ws
    [dron_urdf.urdf, ensamble_dron.stl]
2026-11-10 Analisis de estabilidad
2026-11-10 Quitar carpeta duplicada del análisis de estabilidad
